MaxBarbe/SmartPot_RAK3172/pot_fleur/docs/percages/rapport_percages.txt

Drill report for pot_fleur.kicad_pcb
Created on 2026-10-13T10:01:02

Copper Layer Stackup:
    =============================================================
    L1 :  F.Cu                      front
    L2 :  In1.Cu                    in1
    L3 :  In2.Cu                    in2
    L4 :  B.Cu                      back

Drill file 'pot_fleur-PTH.drl' contains
    plated through holes:
    =============================================================
    T1  0.300mm  0.0118"  (75 holes))
    T2  1.000mm  0.0394"  (22 holes))
    T3  1.300mm  0.0512"  (2 holes))

    Total plated holes count 99

Drill file 'pot_fleur-NPTH.drl' contains
    unplated through holes:
    =============================================================
    T1  3.000mm  0.1181"  (2 holes))

    Total unplated holes count 2
