MaxBarbe/SmartPot_RAK3172/CREDITS.md

# Crédits et provenance

## Projet SmartPot

**Maxime — [MaxBarbe](https://github.com/MaxBarbe)** : projet de pot connecté, conception et essais de l'antenne dans CST, modèle mécanique du pot et captures associées. Les adaptations du projet KiCad et sa documentation ont été préparées avec l'assistance de Codex.

## Base pédagogique

Le dépôt a été initialement dupliqué à partir de [DorianDIANA/EDU_RAK_2026](https://github.com/DorianDIANA/EDU_RAK_2026). Les ressources initiales sont regroupées dans `references/EDU_RAK_2026/`, avec leur README d'origine. L'historique Git est conservé ; cette réorganisation ne réattribue pas les fichiers d'origine à SmartPot.

## Références techniques

- Texas Instruments : BQ25570, note d'application [DN038 / SWRA416](https://www.ti.com/lit/an/swra416/swra416.pdf) et géométrie de référence [SWRR082](https://www.ti.com/lit/zip/swrr082) utilisée pour l'ancienne antenne KiCad.
- RAKwireless : module RAK3172 ; documentation d'origine conservée parmi les ressources pédagogiques.
- Sensirion : SHT40 ; symboles, empreintes et modèle 3D présents dans le projet KiCad.
- Bibliothèques KiCad et fichiers fournisseurs : conserver leurs attributions et conditions propres.

Aucun fichier LICENSE n’était présent dans la base locale. Les fichiers du professeur et des fabricants conservent leur provenance ; aucune nouvelle licence générale ne leur est attribuée.

## Modèles mécaniques de la carte

Le modèle RAK3172 provient du [téléchargement officiel RAKwireless](https://downloads.rakwireless.com/3D_File/WisDuo/3D_RAK3172.stp). Le BQ25570 utilise le modèle de boîtier Texas RGR fourni avec KiCad. Les modèles SHT40 et LPS4018 sont ceux déjà présents dans le projet. Les STEP/GLB assemblés et les images PCB sont exportés de KiCad ; ils ne représentent pas encore un assemblage du PCB dans le pot.
