MaxBarbe/SmartPot_RAK3172/docs/GALERIE.md

# Galerie SmartPot — 28 octobre 2026

## Carte KiCad actuelle : V4 quatre couches

V4 — rendu natif KiCad

[Projet et contrôles](../pot_fleur_v4_nouvelle_antenne/README.md) · [STEP](../pot_fleur_v4_nouvelle_antenne/3D/SmartPot_V4_RF_provisoire.step) · [GLB](../pot_fleur_v4_nouvelle_antenne/3D/SmartPot_V4_RF_provisoire.glb)

## Routage V4

Routage et plans V4

## Résultats CST V4 : maillages M1 et M2

Comparaison S11 V4, résultats non convergés

M2 donne −8,97 dB à 868 MHz ; la convergence n’est pas démontrée. [Résultats et limites](../CST/V4_U112_868/README.md).

## Alimentation et port de simulation V4

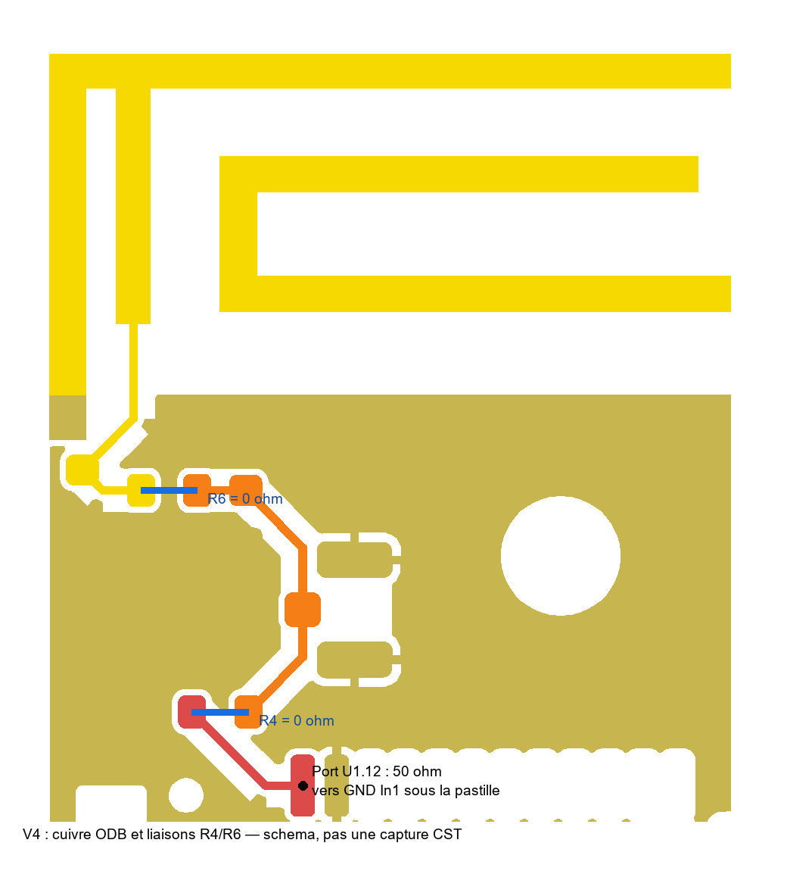
[picture p20: CST/V4_U112_868/captures/V4_raccord_et_port_schema.png]
Schéma explicatif, pas une capture CST


## Pot : conception et assemblage historique

Vue du pot

Assemblage corrigé sous le pot, antérieur à la V4

La capture d’assemblage précède la V4. Utiliser son nouveau STEP pour actualiser le montage mécanique.

[Proposition V5 CST sans résultat publié](../CST/V5_ADAPTATION_868/README.md) · [Archives des versions antérieures](../old/README.md)
