MaxBarbe/SmartPot_RAK3172/CST/V4_U112_868/captures/S11_V4_maillages.pdf

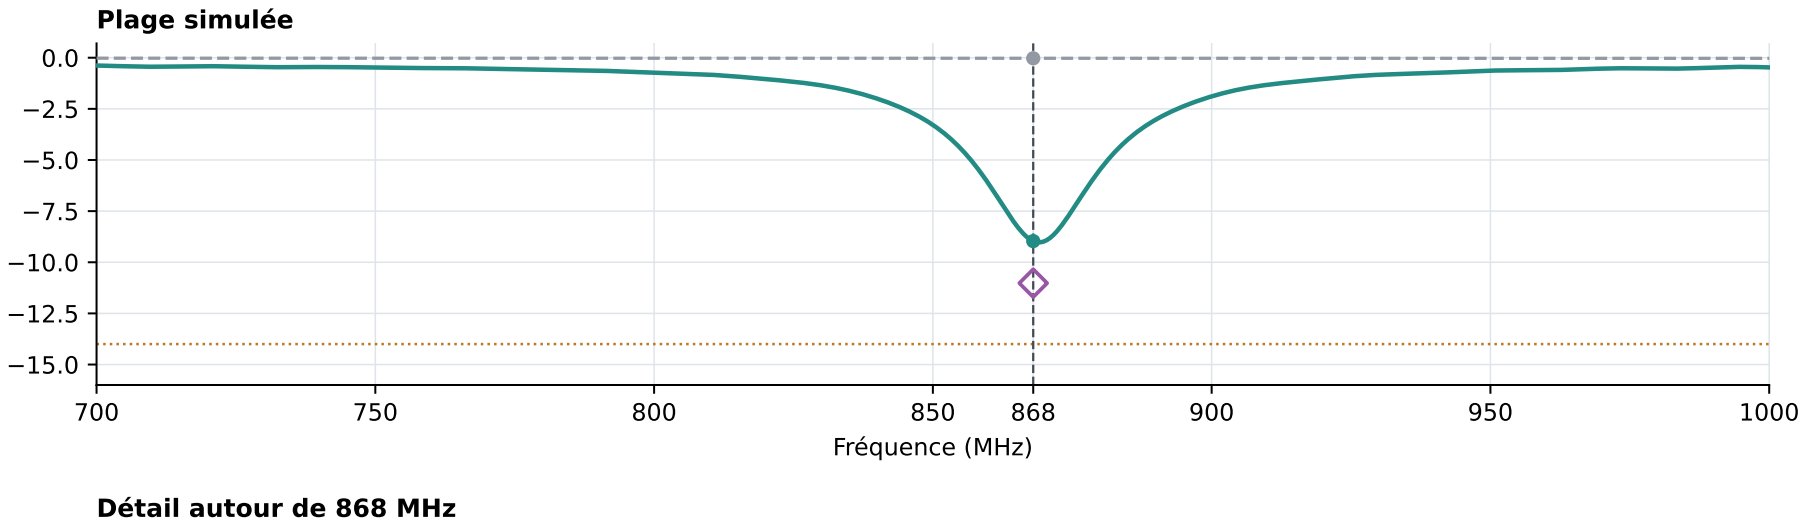
[picture p22: figure]
Fréquence (MHz); Plage simulée; Détail autour de 868 MHz

### S₁₁ (dB)

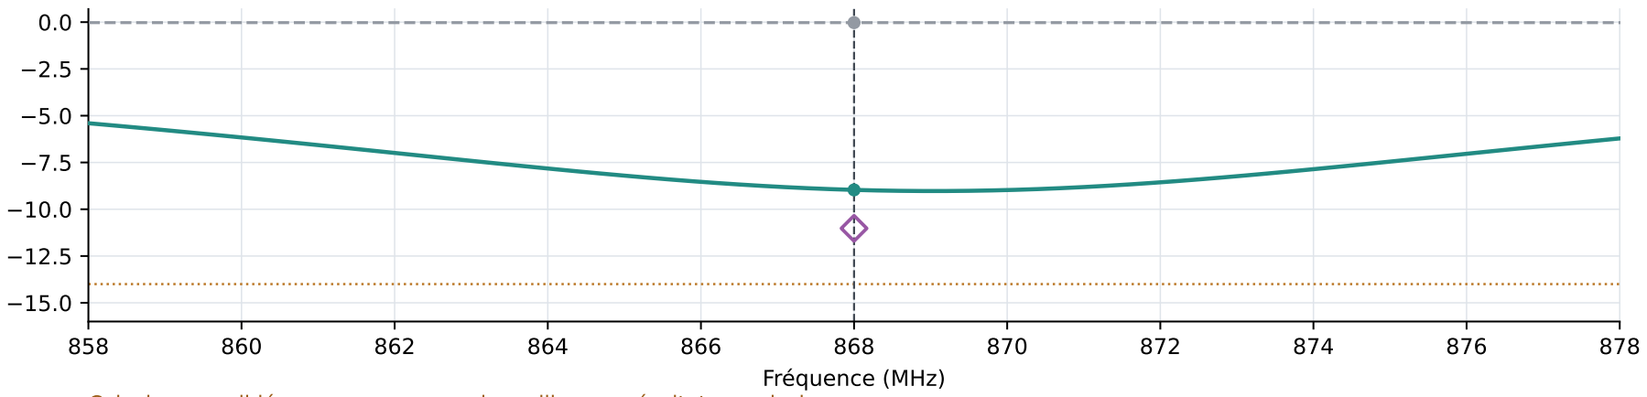
[picture p23: figure]
Fréquence (MHz)

### S₁₁ (dB)

## SmartPot V4 — étude de maillage de S₁₁

Port U1.12 → GND In1 · référence 50 Ω

Calculs non validés par convergence du maillage — résultats provisoires.
Courbes issues des exports natifs CST. X0 : point unique antérieur en fréquentiel, cuivre PEC.
V4 : temporel, cuivre avec pertes. Empilage et modèles de composants provisoires. Objectif évalué à 868 MHz.

V4 M1 — 205 387 cellules
V4 M2 — 770 308 cellules
X0 : point fréquentiel à 868 MHz | Seuil −14 dB
