MaxBarbe/SmartPot_RAK3172/old/README.md

# Anciennes versions SmartPot

Versions antérieures à la V4, archivées le 28 octobre 2026. Elles sont conservées pour comparaison ; la carte KiCad actuelle est la [V4](../pot_fleur_v4_nouvelle_antenne/README.md). La [V5 CST](../CST/V5_ADAPTATION_868/README.md) est une proposition d’adaptation pour simulation.

| Archive | Contenu |
|---|---|
| [pot_fleur](pot_fleur/README.md) | Première carte quatre couches et anciennes intégrations d’antenne |
| [V2 deux couches](pot_fleur_v2_2couches/README.md) | Variante deux couches, exports et contrôles historiques |
| [V3 quatre couches](pot_fleur_v3_provisoire_4couches/README.md) | Corrections du retour enseignant, ancien radiateur et routage |
| [CST initial](CST/TP1_M2_Smart_2-3.cst) | Antenne initiale et variantes -1/-2 dans le même dossier |
| [V3 CST carte complète](CST/V3_ODB_carte_complete/LIRE_AVANT_SIMULATION.md) | Reconstruction, compatibilité CST 2019 et ancien port de comparaison |
| [V3 CST modèle réduit](CST/V3_ODB_modele_reduit/LIRE_AVANT_RESULTATS.md) | Simplifications et résultats préliminaires |
| [Import initial SmartPot_V3_S11](SmartPot_V3_S11.cst) | Ancien projet importé avec son dossier compagnon |
| [Anciennes instructions de reprise](REPRISE_CST_V3.md) | Historique du transfert des projets V3 |

Chaque `.cst` doit rester accompagné de son dossier de même nom lorsqu’il existe. Les résultats et hypothèses de ces modèles ne valident pas automatiquement les versions plus récentes. Les réglages locaux KiCad sont conservés sur le Mac.

Les fichiers X0 dans `../CST/ANTENNE_868_3QUARTS/` restent directement accessibles comme référence de la géométrie utilisée en V4 ; ce dossier n’est pas une autre carte KiCad active.
