MaxBarbe/SmartPot_RAK3172/CST/ANTENNE_868_3QUARTS/captures/CST_vue_globale.png

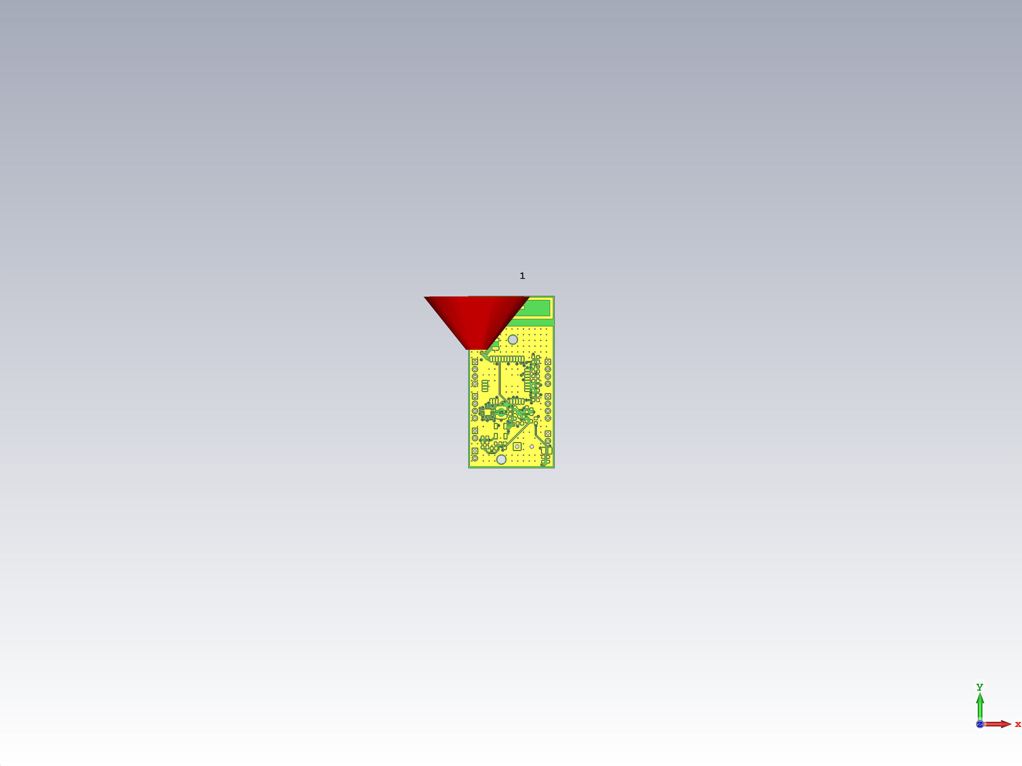
CST/ANTENNE_868_3QUARTS/captures/CST_vue_globale.png
