MaxBarbe/SmartPot_RAK3172/pot_fleur_v3_provisoire_4couches/docs/Calcul_RF_KiCad_provisoire.png

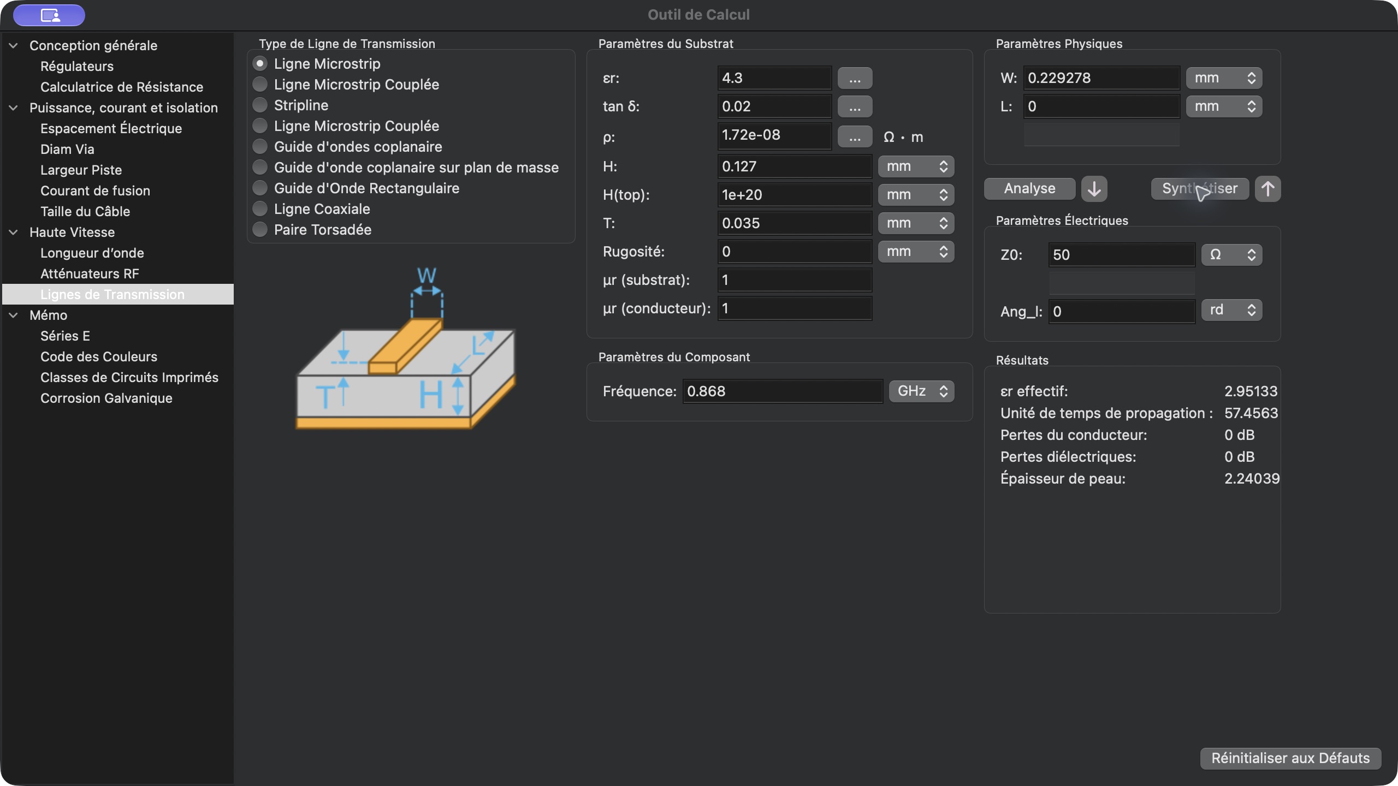
pot_fleur_v3_provisoire_4couches/docs/Calcul_RF_KiCad_provisoire.png
