MaxBarbe/SmartPot_RAK3172/Mecanique/PCB/SmartPot_assemble.step

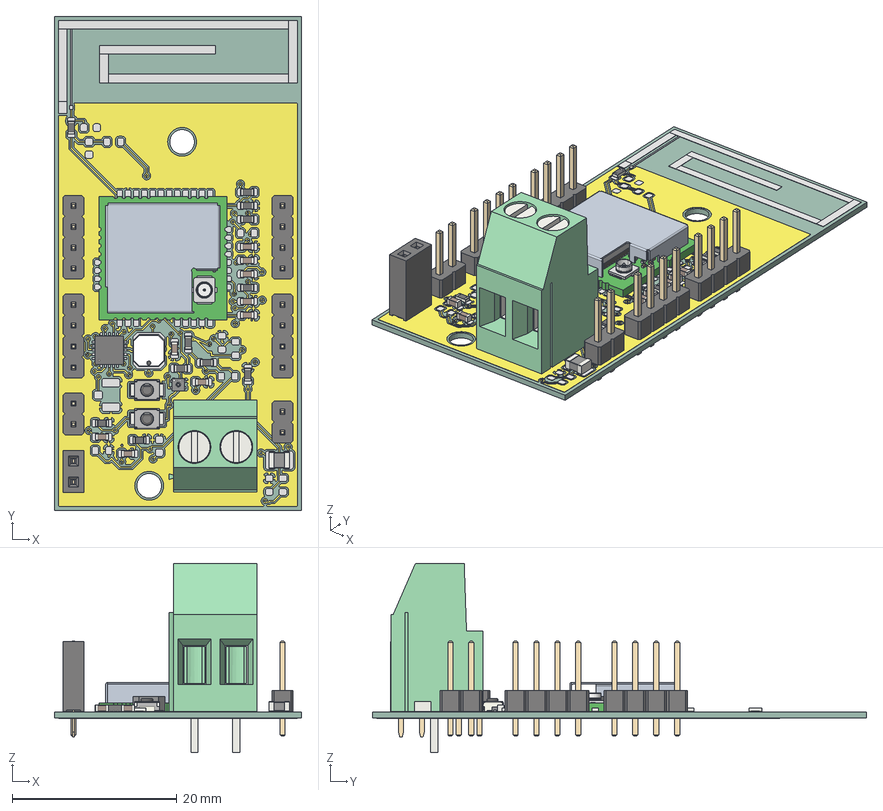
[picture p27: CAD file, 2026-10-13]
Mecanique/PCB/SmartPot_assemble.step
30.0 x 60.0 x 23.0 mm
R_0603_1608Metric x 11
LPS4018-103MRC
0201_SMD_Capacitor x 36
Extruded
R0201 x 7
RES_1005-0402 x 3
QFN48_7x7
NT2016SA
C0402 x 4
crystal_rtf2012
D030A-ǁ±θ
C_0603_1608Metric x 9
149048-00_Publikationsmodell SHT4xA-StandardDFN
PinSocket_1x02_P2.54mm_Vertical
L_1008_2520Metric
SW_SPST_B3U-1000P x 2
PinHeader_1x02_P254mm_Vertical x 2
Texas_VQFN_RGR_20_1EP_35x35mm_Pitch05mm
TerminalBlock_Phoenix_MKDS-3-2-5.08_1x02_P5.08mm_Horizontal
PinHeader_1x04_P254mm_Vertical x 4
pot_fleur_copper
pot_fleur_pad
pot_fleur_via
pot_fleur_PCB
