MaxBarbe/SmartPot_RAK3172/Mecanique/Assemblage/SmartPot_pot_et_PCB.3mf

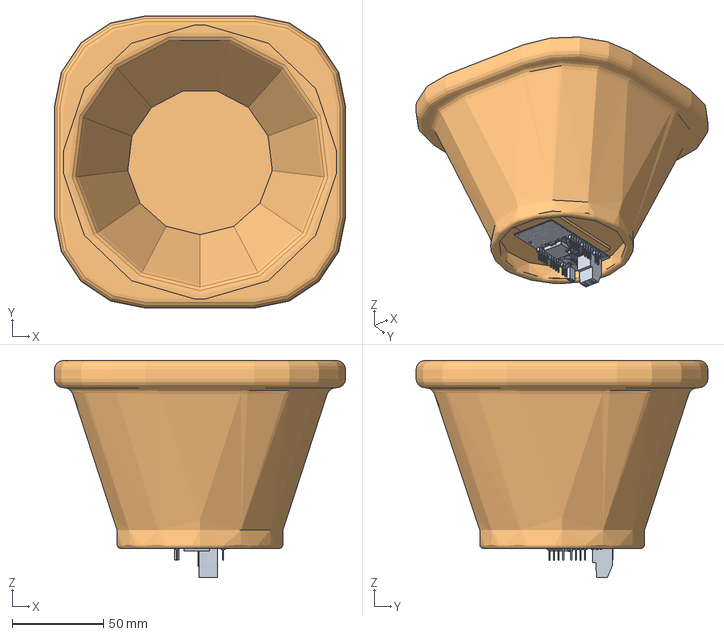
[picture p28: CAD file, 2026-10-12]
Mecanique/Assemblage/SmartPot_pot_et_PCB.3mf
160.0 x 160.4 x 119.2 mm
PCB assemble
Pot_fleur original
