MaxBarbe/SmartPot_RAK3172/Mecanique/PCB/SmartPot_carte_nue.step

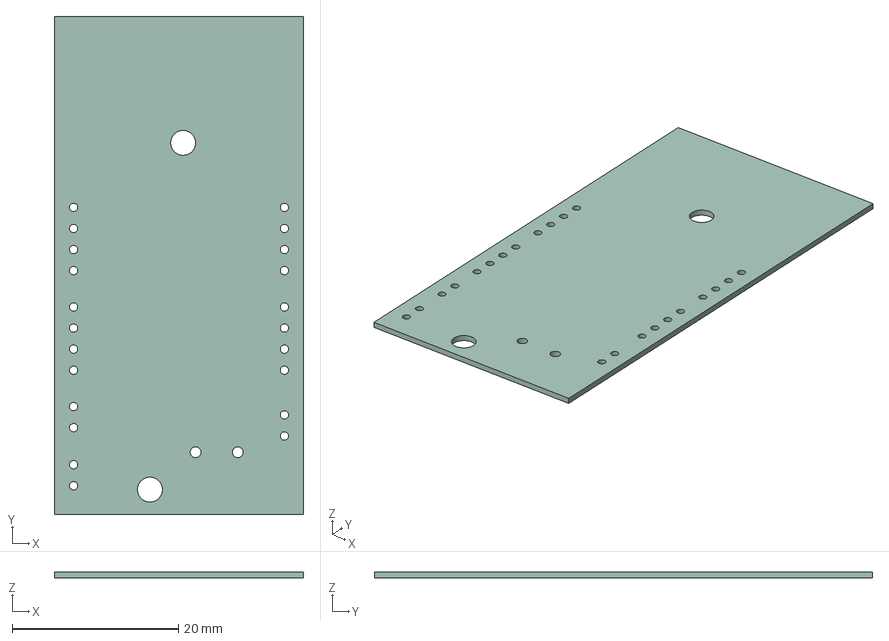
[picture p29: CAD file, 2026-10-13]
Mecanique/PCB/SmartPot_carte_nue.step
30.0 x 60.0 x 0.71 mm
