MaxBarbe/SmartPot_RAK3172/Mecanique/Pot_fleur/Pot_fleur.3mf

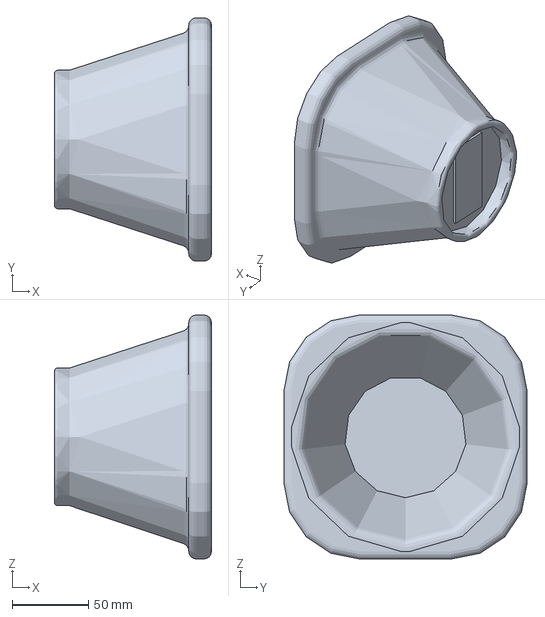
[picture p30: CAD file, 2026-10-12]
Mecanique/Pot_fleur/Pot_fleur.3mf
103.2 x 160.0 x 160.4 mm
