MaxBarbe/SmartPot_RAK3172/pot_fleur/3dmodels/SHT40-AD1B-R2.step

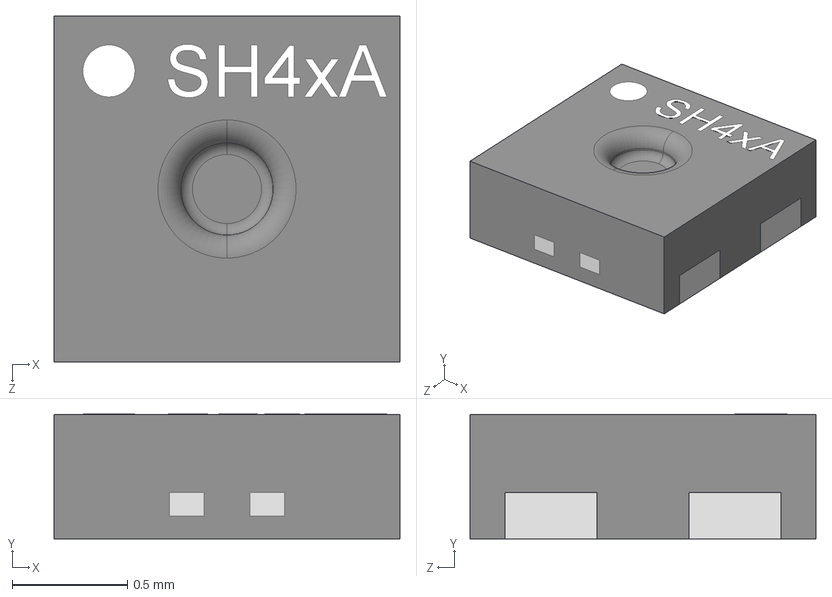
[picture p31: CAD file, 2026-10-05]
pot_fleur/3dmodels/SHT40-AD1B-R2.step
1.50 x 0.541 x 1.50 mm
