MaxBarbe/SmartPot_RAK3172/pot_fleur_v4_nouvelle_antenne/3dmodels/LPS4018-223MRC.step

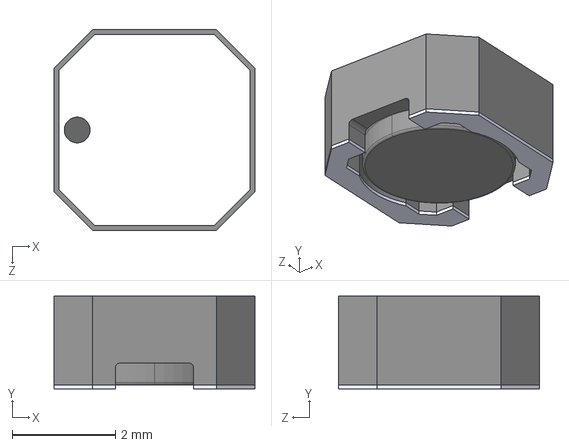
[picture p32: CAD file, 2026-10-07]
pot_fleur_v4_nouvelle_antenne/3dmodels/LPS4018-223MRC.step
3.90 x 1.80 x 3.90 mm
