MaxBarbe/SmartPot_RAK3172/(list of files, cad)

Other CAD files:
pot_fleur_v3_provisoire_4couches/3D/SmartPot_V3_provisoire.step
pot_fleur_v4_nouvelle_antenne/3D/SmartPot_V4_RF_provisoire.step
old/pot_fleur_v3_provisoire_4couches/3D/SmartPot_V3_provisoire.step
Mecanique/Pot_fleur/Pot_fleur.stl
