MaxBarbe/SmartPot_RAK3172/docs/DRC_verification_reorganisation.txt

** Drc report for pot_fleur.kicad_pcb **
** Created on 2026-10-12T12:48:24 **
** Report includes: Errors, Warnings **

** Found 0 DRC violations **

** Found 0 unconnected pads **

** Found 0 Footprint errors **

** Ignored checks **
    - Footprint has no courtyard defined
    - Track endpoint not centered on via
    - Tuning profile track geometries
    - Footprint doesn't match symbol's footprint filters
    - Footprint component type doesn't match footprint pads

** End of Report **
