MaxBarbe/SmartPot_RAK3172/pot_fleur/docs/APERCU_routage_4couches.pdf

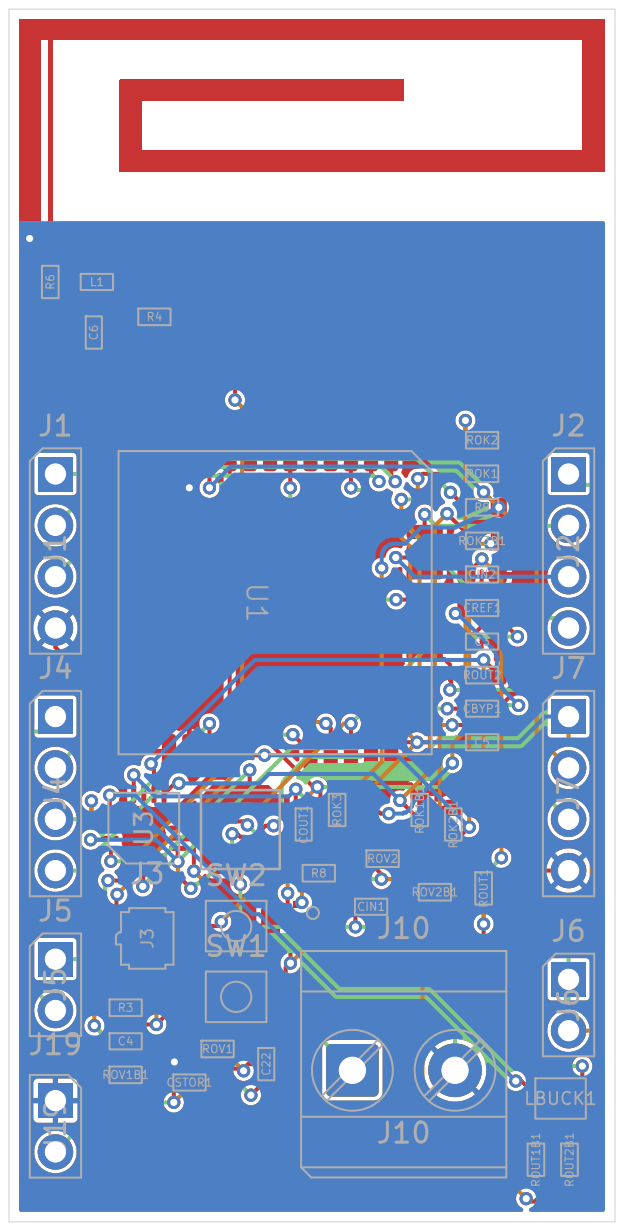
[picture p33: page 1]
