MaxBarbe/SmartPot_RAK3172/old/pot_fleur/docs/APERCU_antenne_CST.pdf

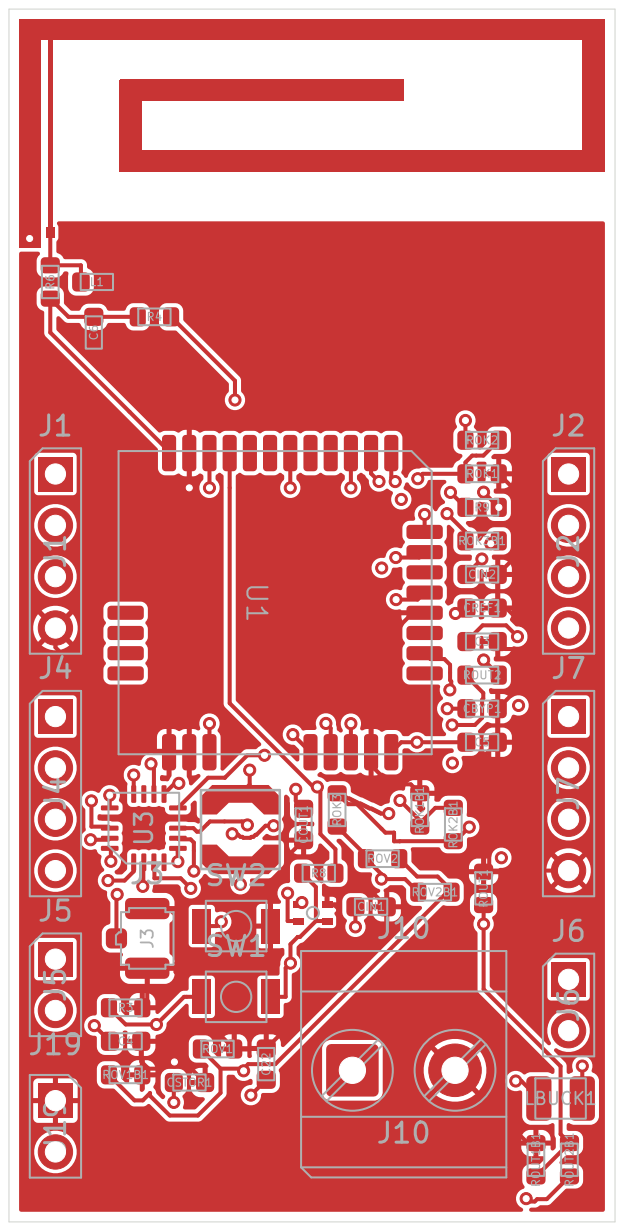
[picture p34: page 1]
