MaxBarbe/SmartPot_RAK3172/(list of files, drawings)

Other design files:
CST/ANTENNE_868_3QUARTS/modeles/SmartPot_V3_ANTENNE_PISTE_HAUT_3QUARTS_LUMP_2019/Model/3D/Model.dsn
CST/V3_ODB_carte_complete/CST2019/SmartPot_V3_PORT_ANTENNE_2019/Model/3D/Model.dsn
old/CST/V3_ODB_carte_complete/SmartPot_V3_PCB_COMPLET/Model/3D/Model.dsn
old/CST/V3_ODB_modele_reduit/SmartPot_V3_ODB_REDUIT/Model/3D/Model.dsn
old/SmartPot_V3_S11/Model/3D/Model.dsn
