MaxBarbe/SmartPot_RAK3172/pot_fleur_v2_2couches/pot_fleur.kicad_pcb

## KiCad design pot_fleur_v2_2couches/pot_fleur.kicad_pcb (2026-10-14)

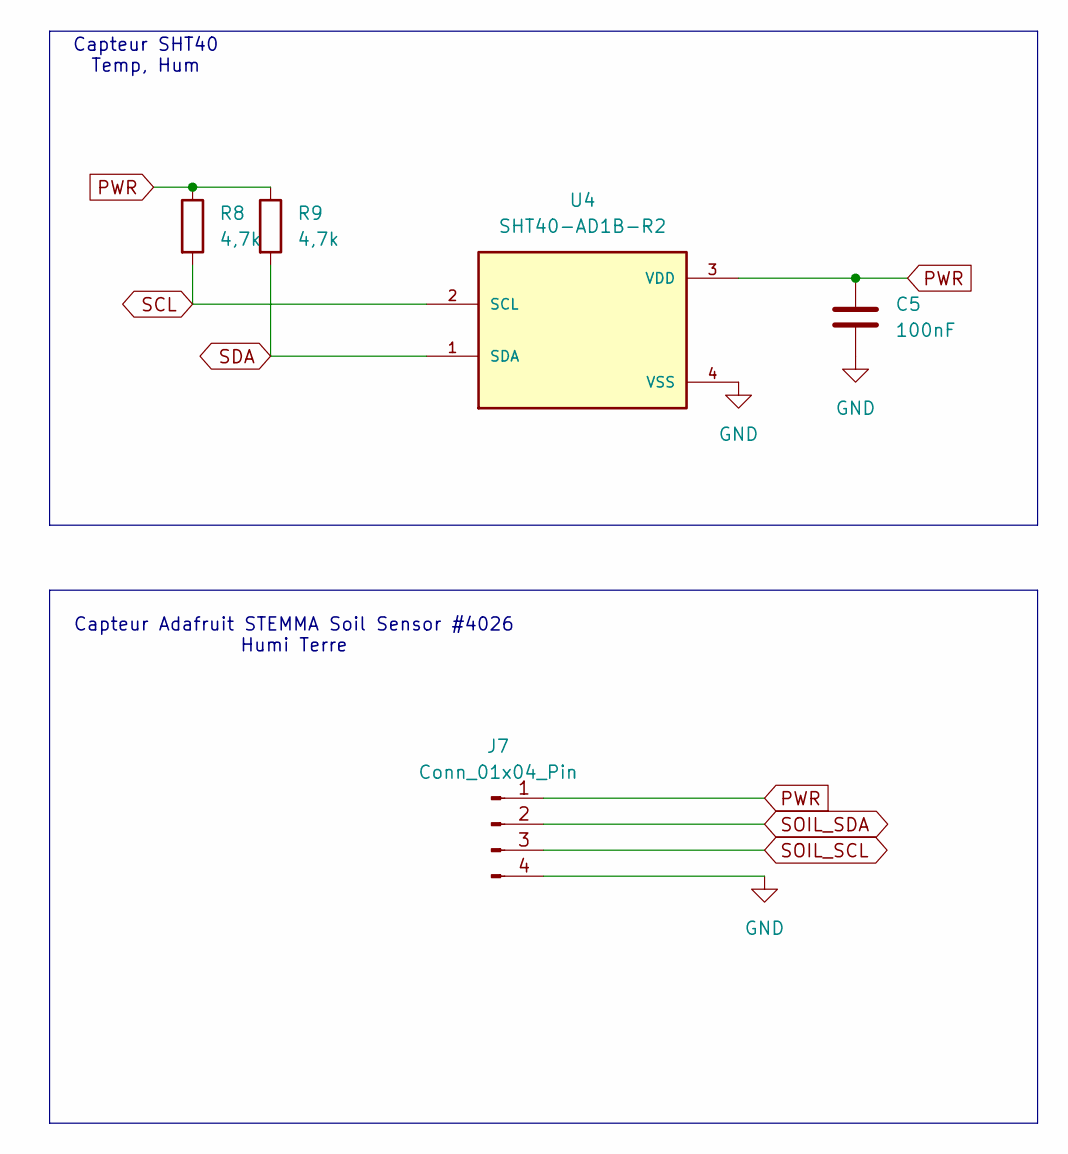
[picture p35: schematic capteur.kicad_sch]

Parts:
C5: 100nF; C_0603_1608Metric
J7: Conn_01x04_Pin; PinHeader_1x04_P2.54mm_Vertical
R8, R9: 4,7k; R_0603_1608Metric
U4: SHT40-AD1B-R2; SHT4X

Connections:
GND: C5.2, J7.4, U4.4 (VSS); also elsewhere on the board
PWR: C5.1, J7.1, R8.1, R9.1, U4.3 (VDD); also elsewhere on the board
SCL: J7.3, R8.2, U4.2 (SCL); also elsewhere on the board
SDA: J7.2, R9.2, U4.1 (SDA); also elsewhere on the board

Notes on the sheet:
Capteur Adafruit STEMMA Soil Sensor #4026 Humi Terre
Capteur SHT40 Temp, Hum

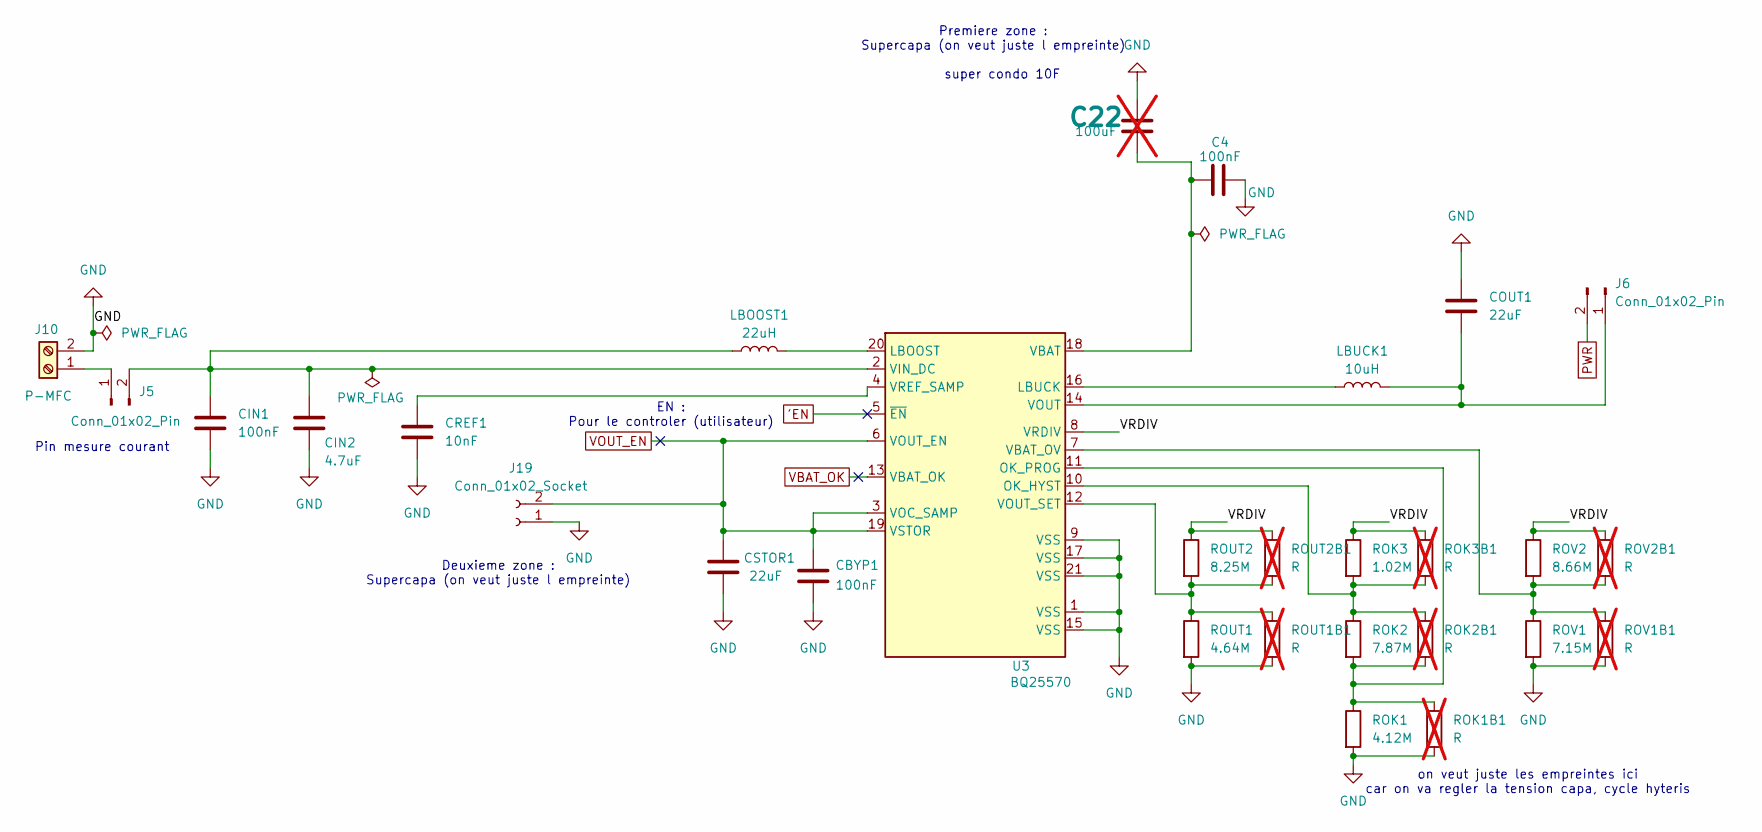
[picture p36: schematic BQ25570.kicad_sch]

Parts:
C4: 100nF; C_0603_1608Metric; LCSC C1591
C22: 100uF; C_0603_1608Metric; not fitted
CBYP1: 100nF; C_0603_1608Metric; LCSC C1591
CIN1: 100nF; C_0603_1608Metric; LCSC C1591
CIN2: 4.7uF; C_0603_1608Metric; LCSC C107368
COUT1: 22uF; C_0603_1608Metric; LCSC C2762594
CREF1: 10nF; C_0603_1608Metric; LCSC C1591
CSTOR1: 22uF; C_0603_1608Metric; LCSC C2762594
J5, J6: Conn_01x02_Pin; PinHeader_1x02_P2.54mm_Vertical; LCSC C3332353
J10: P-MFC; TerminalBlock_Phoenix_MKDS-3-2-5.08_1x02_P5.08mm_Horizontal; LCSC C2683165
J19: Conn_01x02_Socket; PinSocket_1x02_P2.54mm_Vertical; LCSC C5372032
LBOOST1: 22uH; IND_LPS4018-223MRC; LCSC C5441602
LBUCK1: 10uH; L_1008_2520Metric; LCSC C237599
ROK1: 4.12M; R_0603_1608Metric; LCSC C3009313
ROK1B1, ROK2B1, ROK3B1: R; R_0603_1608Metric; not fitted
ROK2: 7.87M; R_0603_1608Metric; LCSC C482913
ROK3: 1.02M; R_0603_1608Metric; LCSC C2930138
ROUT1: 4.64M; R_0603_1608Metric; LCSC C2079741
ROUT1B1, ROUT2B1: R; R_0603_1608Metric; not fitted
ROUT2: 8.25M; R_0603_1608Metric; LCSC C166757
ROV1: 7.15M; R_0603_1608Metric; LCSC C422907
ROV1B1, ROV2B1: R; R_0603_1608Metric; not fitted
ROV2: 8.66M; R_0603_1608Metric; LCSC C4087386
U3: BQ25570; QFN-20-1EP_3.5x3.5mm_P0.5mm_EP2x2mm; LCSC C506250

Connections:
'EN: U3.5 (~EN)
/BQ25570/VRDIV: ROK3.1, ROK3B1.1, ROUT2.1, ROUT2B1.1, ROV2.1, ROV2B1.1, U3.8 (VRDIV)
GND: C4.2, C22.2, CBYP1.2, CIN1.2, CIN2.2, COUT1.1, CREF1.2, CSTOR1.2, J10.2, J19.1, ROK1.2, ROK1B1.2, ROUT1.2, ROUT1B1.2, ROV1.2, ROV1B1.2, U3.1 (VSS), U3.9 (VSS), U3.15 (VSS), U3.17 (VSS), U3.21 (VSS); also elsewhere on the board
unnamed: CIN1.1, CIN2.1, J5.2, LBOOST1.1, U3.2 (VIN_DC)
unnamed: COUT1.2, J6.1, LBUCK1.2, U3.14 (VOUT)
unnamed: J5.1, J10.1
unnamed: LBOOST1.2, U3.20 (LBOOST)
unnamed: LBUCK1.1, U3.16 (LBUCK)
unnamed: ROK2.1, ROK2B1.1, ROK3.2, ROK3B1.2, U3.10 (OK_HYST)
unnamed: ROK1.1, ROK1B1.1, ROK2.2, ROK2B1.2, U3.11 (OK_PROG)
unnamed: C4.1, C22.1, U3.18 (VBAT)
unnamed: ROV1.1, ROV1B1.1, ROV2.2, ROV2B1.2, U3.7 (VBAT_OV)
unnamed: ROUT1.1, ROUT1B1.1, ROUT2.2, ROUT2B1.2, U3.12 (VOUT_SET)
unnamed: CREF1.1, U3.4 (VREF_SAMP)
PWR: J6.2; also elsewhere on the board
VBAT_OK: U3.13 (VBAT_OK)
VOUT_EN: CBYP1.1, CSTOR1.1, J19.2, U3.3 (VOC_SAMP), U3.6 (VOUT_EN), U3.19 (VSTOR)

Notes on the sheet:
on veut juste les empreintes ici car on va regler la tension capa, cycle hyteris
Premiere zone : Supercapa (on veut juste l empreinte)
super condo 10F
Deuxieme zone : Supercapa (on veut juste l empreinte)
EN : Pour le controler (utilisateur)
Pin mesure courant

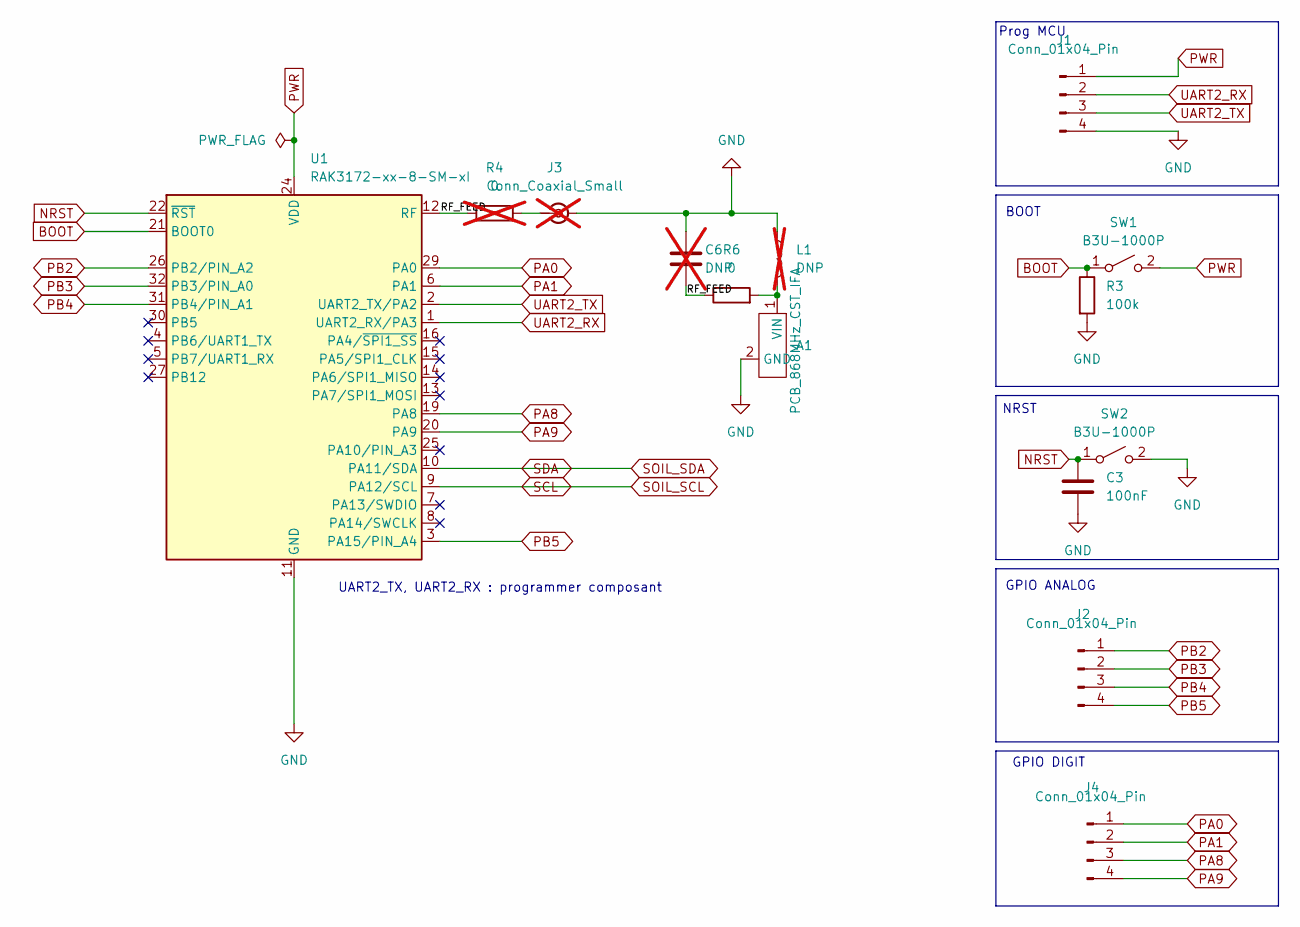
[picture p37: schematic untitled.kicad_sch]

Parts:
A1: PCB_868MHz_CST_IFA; CST_IFA_868MHz_SmartPot
C3: 100nF; C_0603_1608Metric
C6: DNP; C_0603_1608Metric; not fitted
J1, J2, J4: Conn_01x04_Pin; PinHeader_1x04_P2.54mm_Vertical
J3: Conn_Coaxial_Small; U.FL_Hirose_U.FL-R-SMT-1_Vertical; not fitted
L1: DNP; L_0603_1608Metric; not fitted
R3: 100k; R_0603_1608Metric
R4: 0; R_0603_1608Metric; not fitted
R6: 0; R_0603_1608Metric
SW1, SW2: B3U-1000P; SW_SPST_B3U-1000P
U1: RAK3172-xx-8-SM-xI; RAK3172

Connections:
/Microcontroleur/RF_FEED: C6.2, R4.1, R6.1, U1.12 (RF)
BOOT: R3.1, SW1.1 (A), U1.21 (BOOT0)
GND: A1.2 (GND), C3.2, C6.1, J1.4, J3.2 (Ext), L1.1, R3.2, SW2.2 (B), U1.11 (GND), U1.17 (GND), U1.18 (GND), U1.23 (GND), U1.28 (GND); also elsewhere on the board
NRST: C3.1, SW2.1 (A), U1.22 (~RST)
unnamed: A1.1 (VIN), L1.2, R6.2
unnamed: J3.1 (In), R4.2
PA0: J4.1, U1.29 (PA0)
PA1: J4.2, U1.6 (PA1)
PA8: J4.3, U1.19 (PA8)
PA9: J4.4, U1.20 (PA9)
PB2: J2.1, U1.26 (PB2/PIN_A2)
PB3: J2.2, U1.32 (PB3/PIN_A0)
PB4: J2.3, U1.31 (PB4/PIN_A1)
PB5: J2.4, U1.3 (PA15/PIN_A4)
PWR: J1.1, SW1.2 (B), U1.24 (VDD); also elsewhere on the board
SCL: U1.9 (PA12/SCL); also elsewhere on the board
SDA: U1.10 (PA11/SDA); also elsewhere on the board
UART2_RX: J1.2, U1.1 (UART2_RX/PA3)
UART2_TX: J1.3, U1.2 (UART2_TX/PA2)

Notes on the sheet:
UART2_TX, UART2_RX : programmer composant
GPIO DIGIT
Prog MCU
NRST
BOOT
GPIO ANALOG

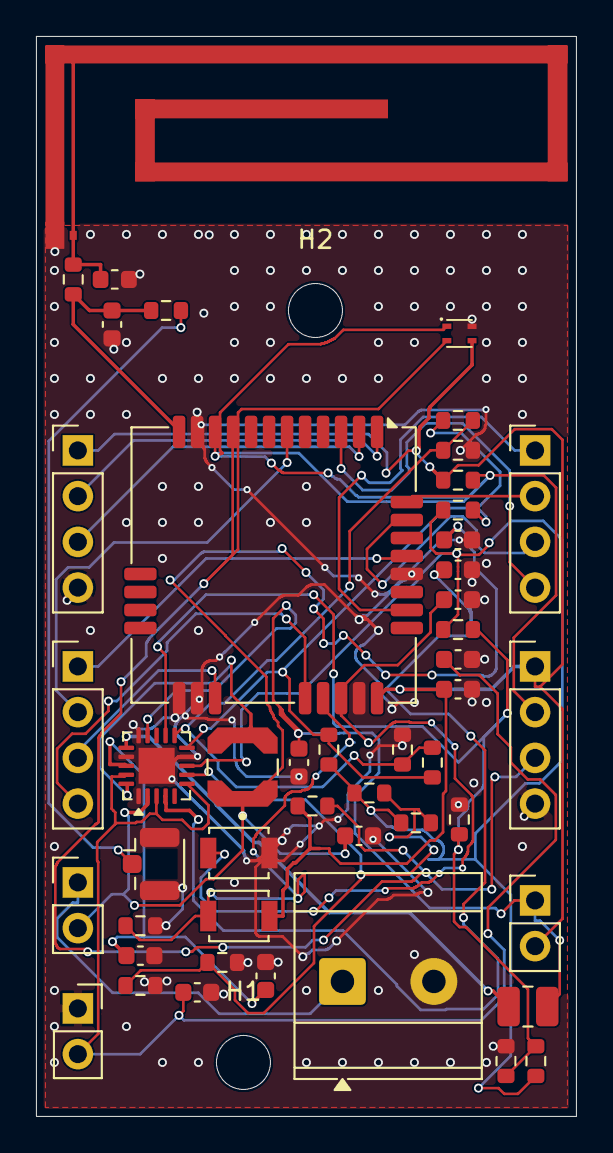
[picture p38: board pot_fleur.kicad_pcb from above]

Board: 2 copper layers, 30.0 x 60.0 mm, 50 parts (0 on the bottom side), 32 nets.

Other parts of the board:
H1, H2: MountingHole_3mm
