MaxBarbe/SmartPot_RAK3172/(commit log)

2026-10-05 Ajout projet KiCad SmartPot
    [BQ25570.kicad_sch, SHT40-AD1B-R2.step, capteur.kicad_sch, pot_fleur.kicad_pcb, pot_fleur.kicad_sch, untitled.kicad_sch]
2026-10-05 Ignore KiCad local history
2026-10-05 Ignore KiCad lock files
2026-10-07 Update SmartPot schematic and BQ25570 configuration
    [BQ25570.kicad_sch, LPS4018-223MRC.step, capteur.kicad_sch, untitled.kicad_sch]
2026-10-07 Add preliminary four-layer routing and 868 MHz PCB antenna
    [BQ25570.kicad_sch, capteur.kicad_sch, pot_fleur.kicad_pcb, untitled.kicad_sch]
2026-10-07 Clean antenna footprint formatting
2026-10-07 Use required 0603 packages for antenna matching network
    [pot_fleur.kicad_pcb, untitled.kicad_sch]
2026-10-12 Present SmartPot project with CST antenna and 3D pot assets
2026-10-12 Replace TI radiator with adapted CST SmartPot IFA antenna
2026-10-12 Add PCB STEP exports and KiCad 3D views to SmartPot gallery
2026-10-12 Add pot and PCB mesh assembly with underside clearance report
2026-10-12 Show corrected Shapr3D pot and PCB assembly in project gallery
2026-10-13 Add two 3 mm mounting drills at marked PCB positions
2026-10-14 Adapt V2 energy input for soldered wires and add mask exports
2026-10-25 Add provisional four-layer V3 addressing Diana PCB review
2026-10-26 Straighten V3 traces and remove redundant pad fragments
2026-10-26 Remove obsolete ground spur from former UFL location
2026-10-26 Audit every V3 trace and remove remaining ground stubs and via fragments
2026-10-26 Add compatible Gerber export and layer reconstruction guide for CST
2026-10-27 Document CST 2019 reconstruction and antenna-port S11 results
2026-10-27 Add top-fed antenna CST geometry and verified 868 MHz result
2026-10-27 Add CST time-domain X+0.40 mm trial and native S11 results
2026-10-27 Clarify selected X0 antenna reference at minus 11 dB
2026-10-28 Publier les projets CST V4 et les résultats temporels M2 provisoires
2026-10-28 Ajouter la V5 CST avec adaptation R6 4.3nH et C6 3.9pF
